Nevada317/wprog/sch/2232/pcb_v10/2232.pdf

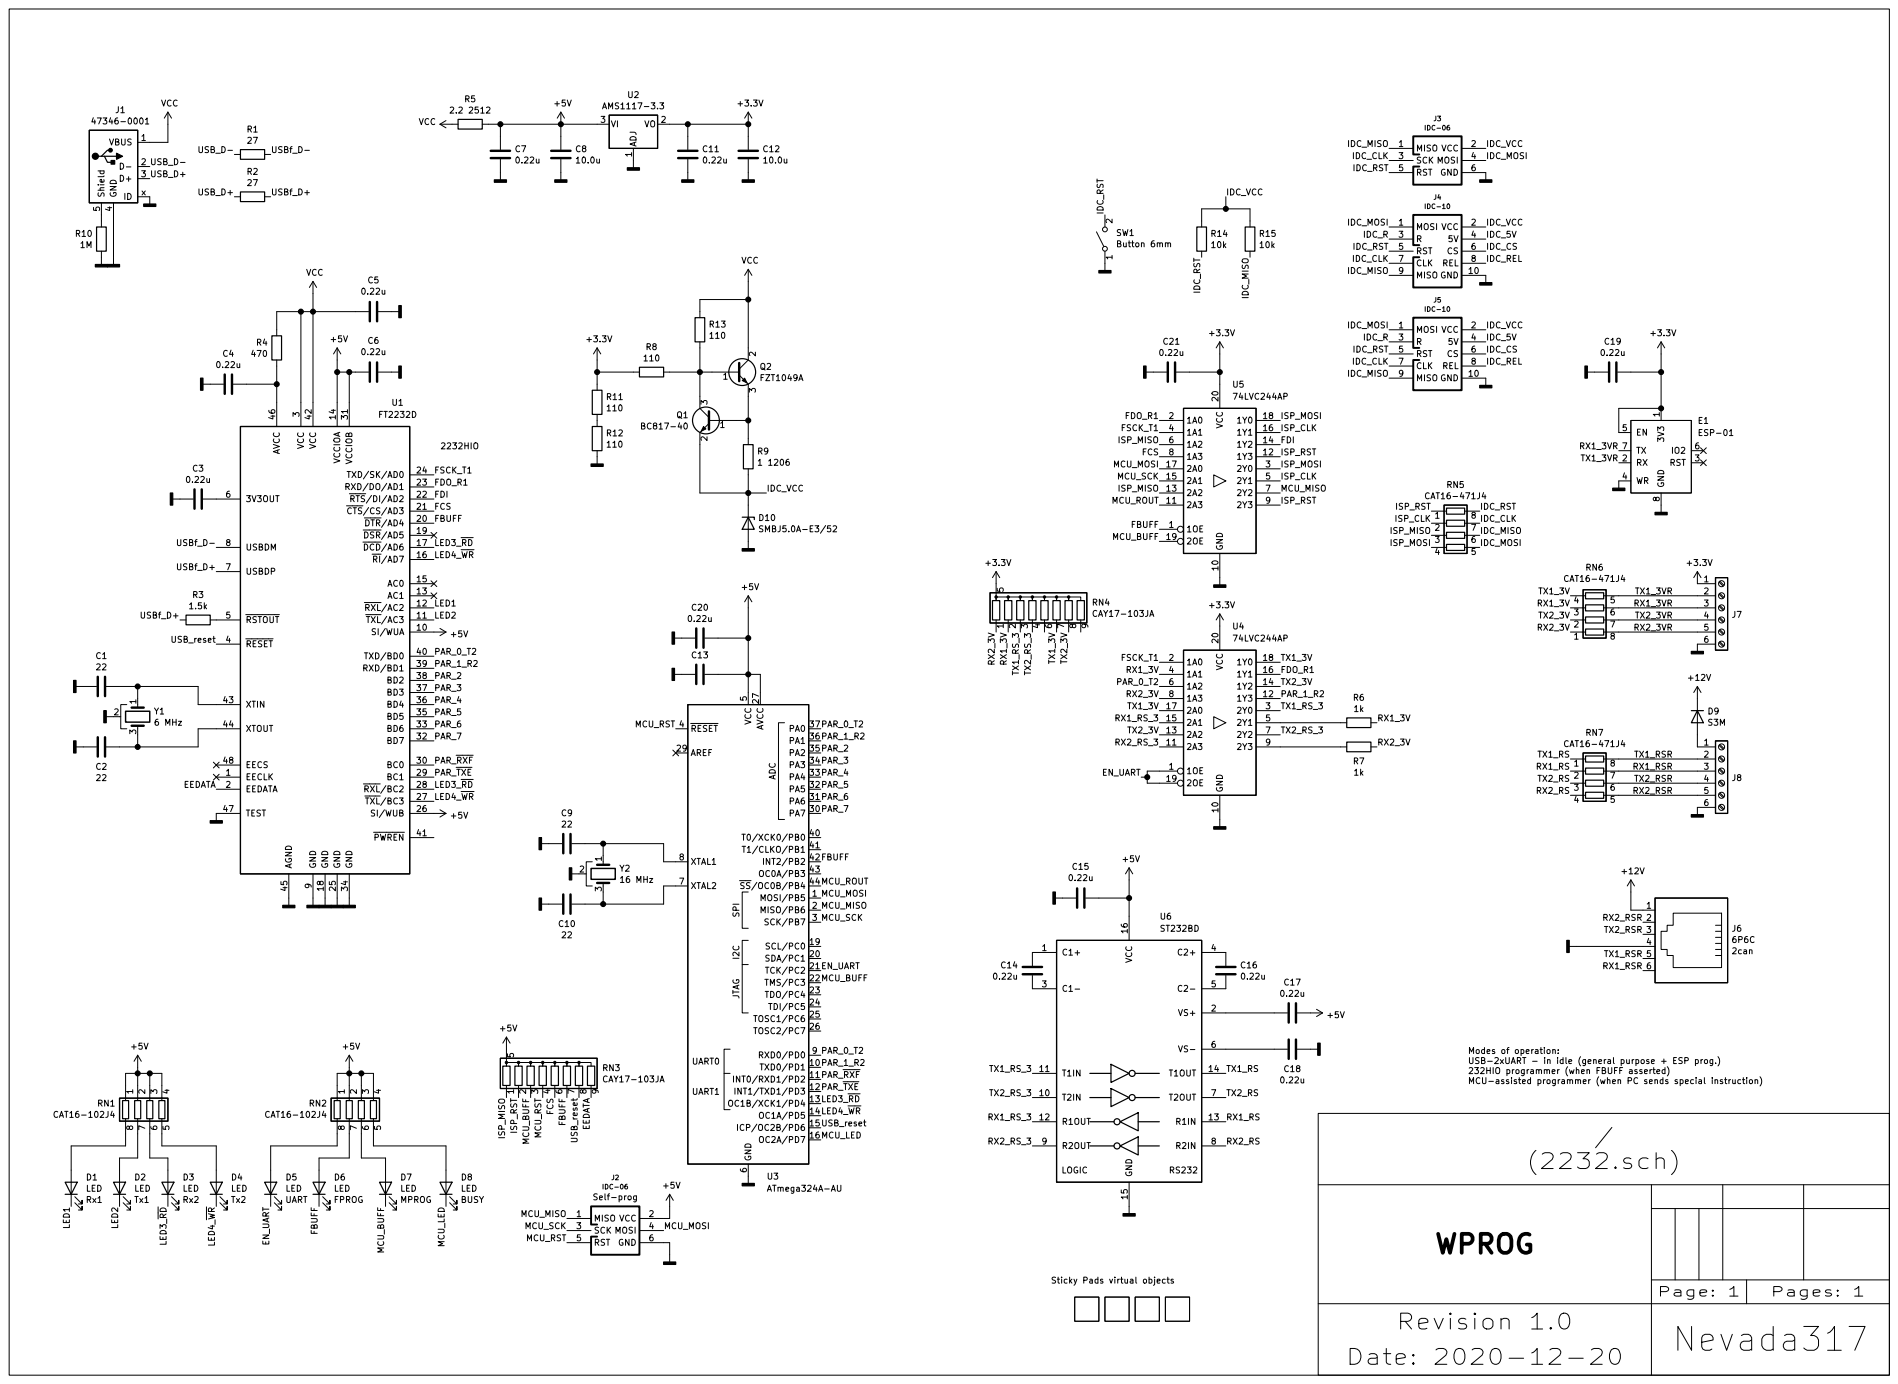
[picture p1: page 1]

3 BC0 30 VCCIOB 31 BD7 32 BD6 33 GND 34 BD5 35 BD4 36 BD3 37 BD2 38 RXD/BD1 39 RESET 4 TXD/BD0 40 PWREN 41 VCC 42 XTIN 43 XTOUT 44 AGND 45 AVCC 46 TEST 47 EECS 48 RSTOUT 5

Modes of operation:
USB-2xUART - in idle (general purpose + ESP prog.)
232HIO programmer (when FBUFF asserted)
MCU-assisted programmer (when PC sends special instruction)

WPROG

Sticky Pads virtual objects

Revision 1.0 Date: 2020-12-20 | Nevada317
