Nevada317/wprog/sch/2232/2232.kicad_pcb

## KiCad design sch/2232/2232.kicad_pcb (2020-12-20)

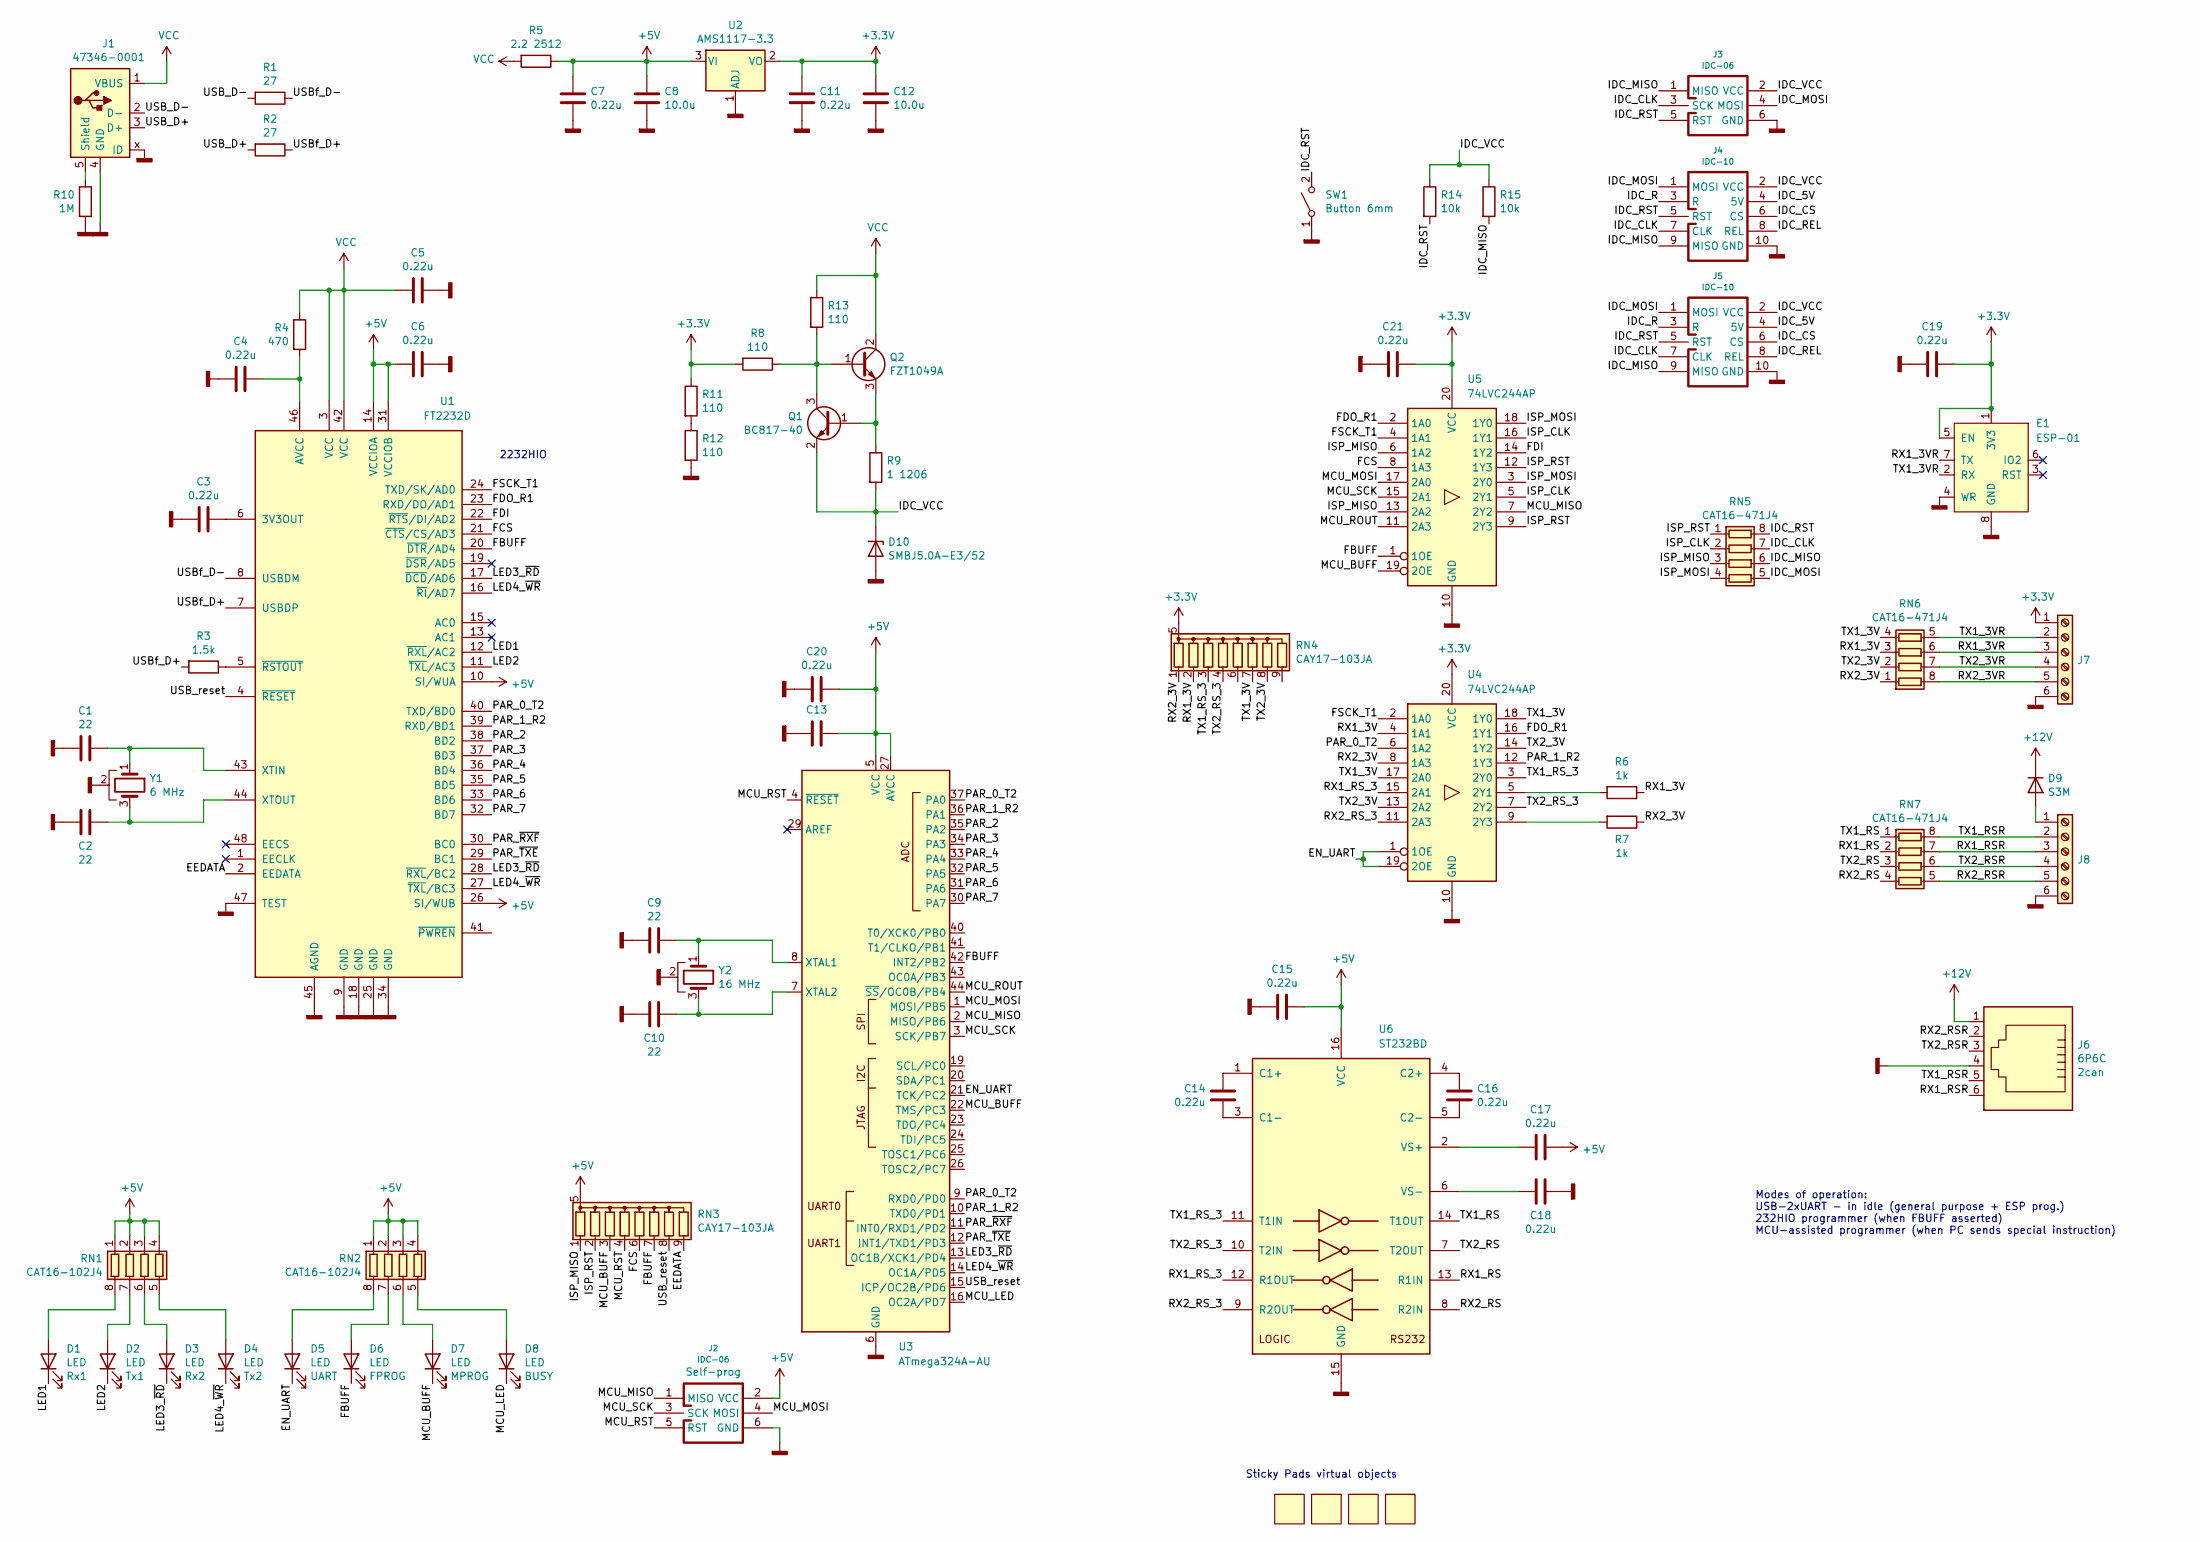
[picture p2: schematic 2232.sch, WPROG]

Parts:
C1, C2, C9, C10: 22; C_0603
C3, C4, C5, C6, C7, C11, C13, C14, C15, C16, C17, C18, C19, C20, C21: 0.22u; C_0603
C8, C12: 10.0u; C_1206
D1, D2, D3, D4, D5, D6, D7, D8: LED; LED_KP-2012G
D9: S3M; DO-214AB_SMC
D10: SMBJ5.0A-E3/52; DO-214AA_SMB
E1: ESP-01
J1: 47346-0001; USB_micro_47346
J2: IDC-06; PLD-6
J3: IDC-06; IDC_Header_Straight_6pins
J4, J5: IDC-10; IDC_Header_Straight_10pins
J6: 6P6C; TJ1A-6P6C_new
J7, J8: Screw_Terminal_01x06; Terminal_3.5mm_x6
Q1: BC817-40; SOT-23
Q2: FZT1049A; SOT-223
R1, R2: 27; R_0603
R3: 1.5k; R_0603
R4: 470; R_0603
R5: 2.2 2512; R_2512
R6, R7: 1k; R_0603
R8, R11, R12, R13: 110; R_0603
R9: 1 1206; R_1206
R10: 1M; R_0603
R14, R15: 10k; R_0603
RN1, RN2: CAT16-102J4; R_CAT-16-4
RN3, RN4: CAY17-103JA; R_CAY17
RN5, RN6, RN7: CAT16-471J4; R_CAT-16-4
SW1: Button 6mm; SW_PUSH_6mm
U1: FT2232D; LQFP-48_7x7mm_P0.5mm
U2: AMS1117-3.3; SOT-223
U3: ATmega324A-AU; TQFP-44
U4, U5: 74LVC244AP; TSSOP-20
U6: ST232BD; SOIC-16
V1, V2, V3, V4: Virtual; StickyPad_13mm
Y1: 6 MHz; Crystal_HC-49SMD
Y2: 16 MHz; Crystal_HC-49SMD

Connections:
+3V3: C11.1, C12.1, C19.1, C21.1, E1.1 (3V3), E1.5 (EN), J7.1, R8.2, R11.1, RN4.5 (common), RN4.10 (common), U2.2 (VO), U4.20 (VCC), U5.20 (VCC)
+5V: C6.1, C7.1, C8.1, C13.1, C15.2, C17.1, C20.1, J2.2 (VCC), R5.1, RN1.1 (R1.1), RN1.2 (R2.1), RN1.3 (R3.1), RN1.4 (R4.1), RN2.1 (R1.1), RN2.2 (R2.1), RN2.3 (R3.1), RN2.4 (R4.1), RN3.5 (common), RN3.10 (common), U1.10 (SI/WUA), U1.14 (VCCIOA), U1.26 (SI/WUB), U1.31 (VCCIOB), U2.3 (VI), U3.5 (VCC), U3.17 (VCC), U3.27 (AVCC), U3.38 (VCC), U6.16 (VCC)
+12V: D9.1 (K), J6.1
/EEDATA: RN3.9 (R8), U1.2 (EEDATA)
/EN_UART: D5.1 (K), U3.21 (TCK/PC2), U4.1 (1OE), U4.19 (2OE)
/FBUFF: D6.1 (K), RN3.7 (R6), U1.20 (~DTR~/AD4), U3.42 (INT2/PB2), U5.1 (1OE)
/FCS: RN3.6 (R5), U1.21 (~CTS~/CS/AD3), U5.8 (1A3)
/FDI: U1.22 (~RTS~/DI/AD2), U5.14 (1Y2)
/FDO_R1: U1.23 (RXD/DO/AD1), U4.16 (1Y1), U5.2 (1A0)
/FSCK_T1: U1.24 (TXD/SK/AD0), U4.2 (1A0), U5.4 (1A1)
/IDC_5V: J4.4 (5V), J5.4 (5V)
/IDC_CLK: J3.3 (SCK), J4.7 (CLK), J5.7 (CLK), RN5.7 (R2.2)
/IDC_CS: J4.6 (CS), J5.6 (CS)
/IDC_MISO: J3.1 (MISO), J4.9 (MISO), J5.9 (MISO), R15.2, RN5.6 (R3.2)
/IDC_MOSI: J3.4 (MOSI), J4.1 (MOSI), J5.1 (MOSI), RN5.5 (R4.2)
/IDC_R: J4.3 (R), J5.3 (R)
/IDC_REL: J4.8 (REL), J5.8 (REL)
/IDC_RST: J3.5 (RST), J4.5 (RST), J5.5 (RST), R14.2, RN5.8 (R1.2), SW1.2 (B)
/IDC_VCC: D10.1 (K), J3.2 (VCC), J4.2 (VCC), J5.2 (VCC), Q1.2 (E), R9.2, R14.1, R15.1
/ISP_CLK: RN5.2 (R2.1), U5.5 (2Y1), U5.16 (1Y1)
/ISP_MISO: RN3.1 (R1), RN5.3 (R3.1), U5.6 (1A2), U5.13 (2A2)
/ISP_MOSI: RN5.4 (R4.1), U5.3 (2Y0), U5.18 (1Y0)
/ISP_RST: RN3.2 (R2), RN5.1 (R1.1), U5.9 (2Y3), U5.12 (1Y3)
/LED1: D1.1 (K), U1.12 (~RXL~/AC2)
/LED2: D2.1 (K), U1.11 (~TXL~/AC3)
/LED3_~RD: D3.1 (K), U1.17 (~DCD~/AD6), U1.28 (~RXL~/BC2), U3.13 (OC1B/XCK1/PD4)
/LED4_~WR: D4.1 (K), U1.16 (~RI~/AD7), U1.27 (~TXL~/BC3), U3.14 (OC1A/PD5)
/MCU_BUFF: D7.1 (K), RN3.3 (R3), U3.22 (TMS/PC3), U5.19 (2OE)
/MCU_LED: D8.1 (K), U3.16 (OC2A/PD7)
/MCU_MISO: J2.1 (MISO), U3.2 (MISO/PB6), U5.7 (2Y2)
/MCU_MOSI: J2.4 (MOSI), U3.1 (MOSI/PB5), U5.17 (2A0)
/MCU_ROUT: U3.44 (~SS~/OC0B/PB4), U5.11 (2A3)
/MCU_RST: J2.5 (RST), RN3.4 (R4), U3.4 (~RESET)
/MCU_SCK: J2.3 (SCK), U3.3 (SCK/PB7), U5.15 (2A1)
/PAR_0_T2: U1.40 (TXD/BD0), U3.9 (RXD0/PD0), U3.37 (PA0), U4.6 (1A2)
/PAR_1_R2: U1.39 (RXD/BD1), U3.10 (TXD0/PD1), U3.36 (PA1), U4.12 (1Y3)
/PAR_2: U1.38 (BD2), U3.35 (PA2)
/PAR_3: U1.37 (BD3), U3.34 (PA3)
/PAR_4: U1.36 (BD4), U3.33 (PA4)
/PAR_5: U1.35 (BD5), U3.32 (PA5)
/PAR_6: U1.33 (BD6), U3.31 (PA6)
/PAR_7: U1.32 (BD7), U3.30 (PA7)
/PAR_~RXF: U1.30 (BC0), U3.11 (INT0/RXD1/PD2)
/PAR_~TXE: U1.29 (BC1), U3.12 (INT1/TXD1/PD3)
/RX1_3V: R6.1, RN4.2 (R2), RN6.3 (R3.1), U4.4 (1A1)
/RX1_3VR: E1.7 (TX), J7.3, RN6.6 (R3.2)
/RX1_RS: RN7.2 (R2.1), U6.13 (R1IN)
/RX1_RSR: J6.6, J8.3, RN7.7 (R2.2)
/RX1_RS_3: U4.15 (2A1), U6.12 (R1OUT)
/RX2_3V: R7.1, RN4.1 (R1), RN6.1 (R1.1), U4.8 (1A3)
/RX2_3VR: J7.5, RN6.8 (R1.2)
/RX2_RS: RN7.4 (R4.1), U6.8 (R2IN)
/RX2_RSR: J6.2, J8.5, RN7.5 (R4.2)
/RX2_RS_3: U4.11 (2A3), U6.9 (R2OUT)
/TX1_3V: RN4.7 (R6), RN6.4 (R4.1), U4.17 (2A0), U4.18 (1Y0)
/TX1_3VR: E1.2 (RX), J7.2, RN6.5 (R4.2)
/TX1_RS: RN7.1 (R1.1), U6.14 (T1OUT)
/TX1_RSR: J6.5, J8.2, RN7.8 (R1.2)
/TX1_RS_3: RN4.3 (R3), U4.3 (2Y0), U6.11 (T1IN)
/TX2_3V: RN4.8 (R7), RN6.2 (R2.1), U4.13 (2A2), U4.14 (1Y2)
/TX2_3VR: J7.4, RN6.7 (R2.2)
/TX2_RS: RN7.3 (R3.1), U6.7 (T2OUT)
/TX2_RSR: J6.3, J8.4, RN7.6 (R3.2)
/TX2_RS_3: RN4.4 (R4), U4.7 (2Y2), U6.10 (T2IN)
/USB_D+: J1.3 (D+), R2.2
/USB_D-: J1.2 (D-), R1.2
/USB_reset: RN3.8 (R7), U1.4 (~RESET), U3.15 (ICP/OC2B/PD6)
/USBf_D+: R2.1, R3.2, U1.7 (USBDP)
/USBf_D-: R1.1, U1.8 (USBDM)
GNDD: C1.2, C2.2, C3.2, C4.2, C5.2, C6.2, C7.2, C8.2, C9.2, C10.2, C11.2, C12.2, C13.2, C15.1, C18.1, C19.2, C20.2, C21.2, D10.2 (A), E1.4 (WR), E1.8 (GND), J1.4 (GND), J1.x (ID), J2.6 (GND), J3.6 (GND), J4.10 (GND), J5.10 (GND), J6.4, J7.6, J8.6, R10.2, R12.2, SW1.1 (A), U1.9 (GND), U1.18 (GND), U1.25 (GND), U1.34 (GND), U1.45 (AGND), U1.47 (TEST), U2.1 (ADJ), U3.6 (GND), U3.18 (GND), U3.28 (GND), U3.39 (GND), U4.10 (GND), U5.10 (GND), U6.15 (GND), Y1.2, Y2.2
unnamed: C1.1, U1.43 (XTIN), Y1.1
unnamed: C2.1, U1.44 (XTOUT), Y1.3
unnamed: C3.1, U1.6 (3V3OUT)
unnamed: C4.1, R4.2, U1.46 (AVCC)
unnamed: C9.1, U3.8 (XTAL1), Y2.1
unnamed: C10.1, U3.7 (XTAL2), Y2.3
unnamed: C14.1, U6.1 (C1+)
unnamed: C14.2, U6.3 (C1-)
unnamed: C16.1, U6.4 (C2+)
unnamed: C16.2, U6.5 (C2-)
unnamed: C17.2, U6.2 (VS+)
unnamed: C18.2, U6.6 (VS-)
unnamed: D1.2 (A), RN1.8 (R1.2)
unnamed: D2.2 (A), RN1.7 (R2.2)
unnamed: D3.2 (A), RN1.6 (R3.2)
unnamed: D4.2 (A), RN1.5 (R4.2)
unnamed: D5.2 (A), RN2.8 (R1.2)
unnamed: D6.2 (A), RN2.7 (R2.2)
unnamed: D7.2 (A), RN2.6 (R3.2)
unnamed: D8.2 (A), RN2.5 (R4.2)
unnamed: D9.2 (A), J8.1
unnamed: J1.5 (Shield), R10.1
unnamed: Q1.1 (B), Q2.3 (E), R9.1
unnamed: Q1.3 (C), Q2.1 (B), R8.1, R13.2
unnamed: R3.1, U1.5 (~RSTOUT)
unnamed: R6.2, U4.5 (2Y1)
unnamed: R7.2, U4.9 (2Y3)
unnamed: R11.2, R12.1
VCC: C5.1, J1.1 (VBUS), Q2.2 (C), R4.1, R5.2, R13.1, U1.3 (VCC), U1.42 (VCC)

Notes on the sheet:
2232HIO
Modes of operation: USB-2xUART - in idle (general purpose + ESP prog.) 232HIO programmer (when FBUFF asserted) MCU-assisted programmer (when PC sends special instruction)
Sticky Pads virtual objects

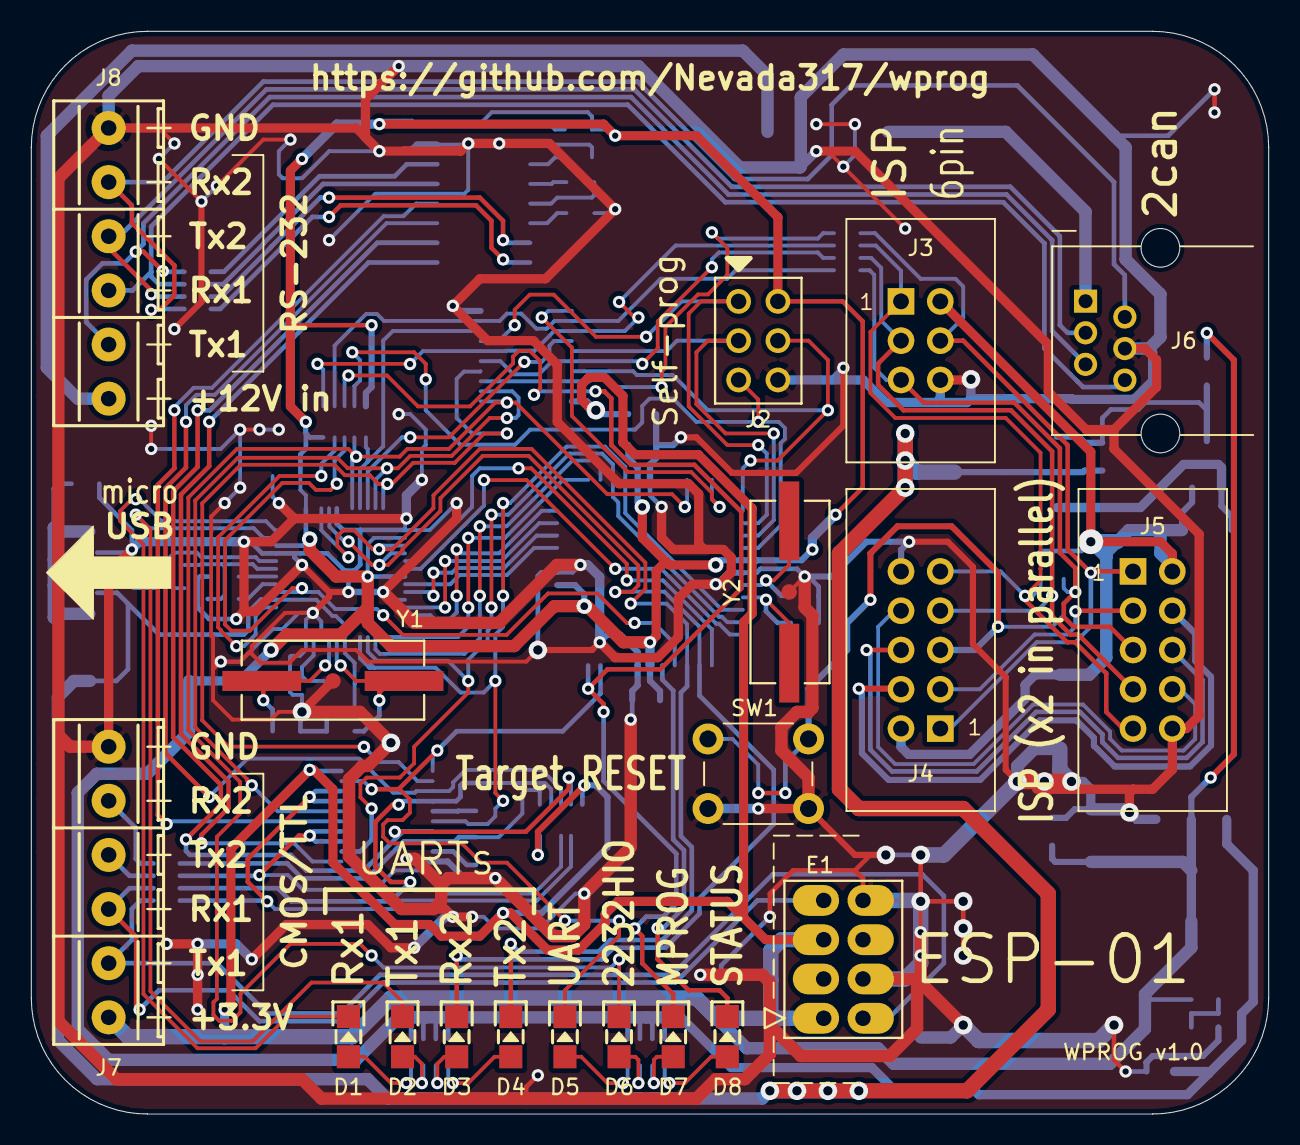
[picture p3: board 2232.kicad_pcb from above]

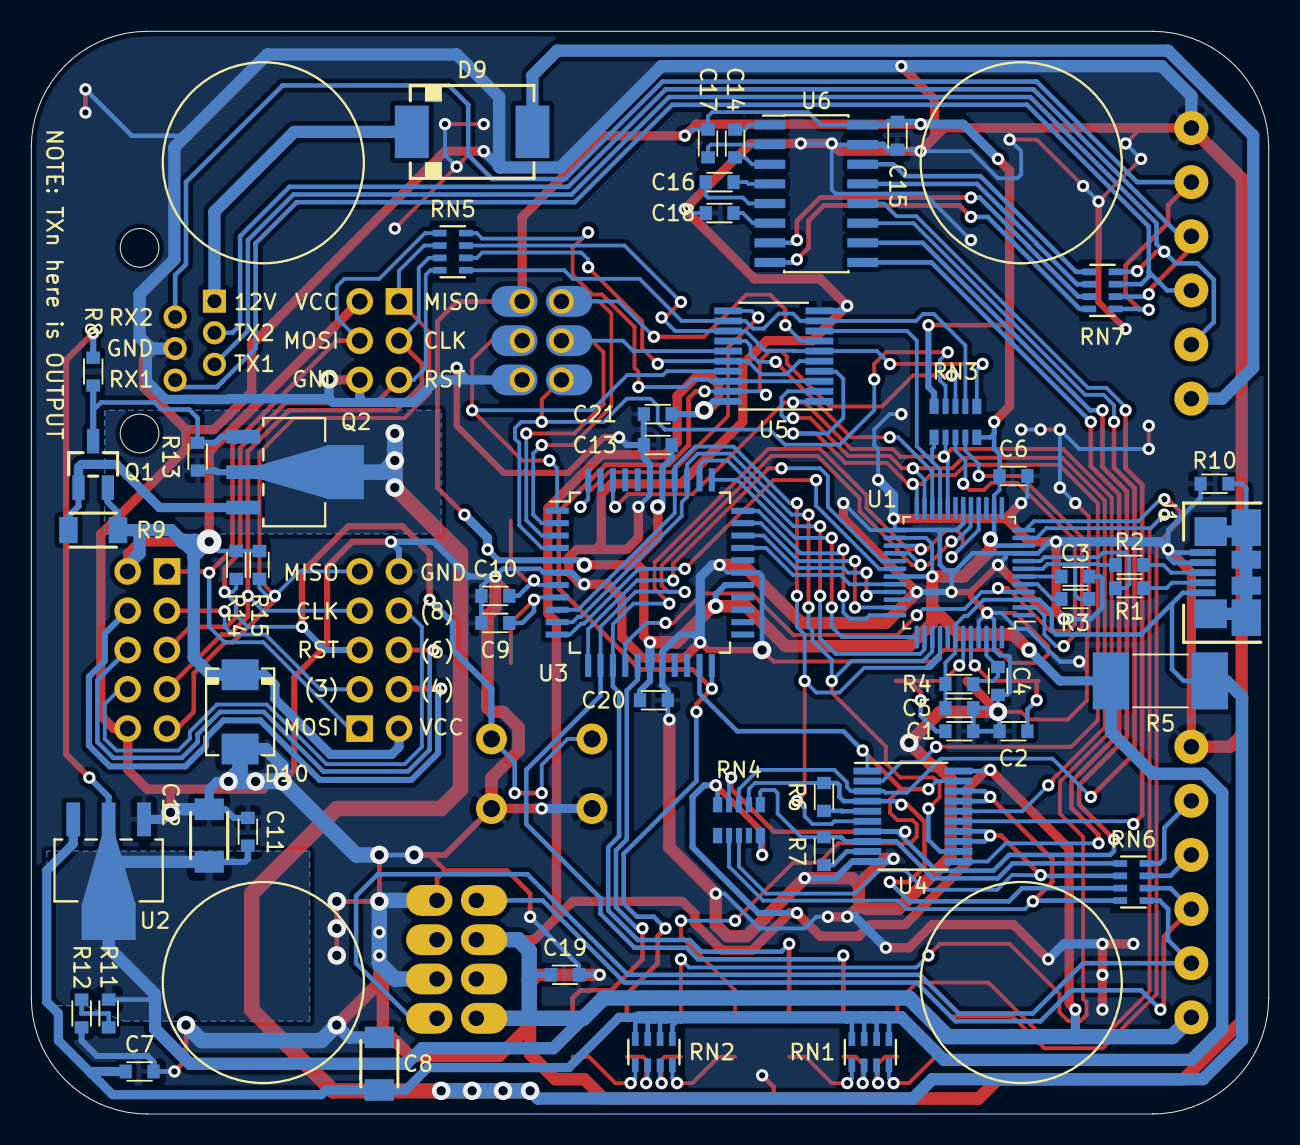
[picture p4: board 2232.kicad_pcb from below]

Board: 2 copper layers, 80.0 x 70.0 mm, 77 parts (58 on the bottom side), 99 nets.
