Nevada317/wprog/(commit log)

2020-12-11 Schematic stub
    [2232.kicad_pcb, 2232.sch]
2020-12-12 Strobes added
    [2232.sch]
2020-12-12 HC138 added
    [2232.sch]
2020-12-12 Names fixed. Footprints assigned
    [2232.sch]
2020-12-12 Annotated. PCB exported
    [2232.kicad_pcb]
2020-12-12 PCB orientation stub
    [2232.kicad_pcb, 2232.sch]
2020-12-12 UART multiplexing
    [2232.kicad_pcb, 2232.sch]
2020-12-13 Routing started
    [2232.kicad_pcb, 2232.sch]
2020-12-14 UARTs routed trough connectors
    [2232.kicad_pcb, 2232.sch]
2020-12-14 All components on-board
    [2232.kicad_pcb, 2232.sch]
2020-12-14 RN remap
    [2232.kicad_pcb, 2232.sch]
2020-12-14 Sides separated
    [2232.kicad_pcb]
2020-12-14 ISP routed
    [2232.kicad_pcb]
2020-12-14 All footprinted elements are routed
    [2232.kicad_pcb, 2232.sch]
2020-12-15 VCC routed
    [2232.kicad_pcb, 2232.sch]
2020-12-15 IDC rotated
    [2232.kicad_pcb]
2020-12-16 No-fill zones
    [2232.kicad_pcb]
2020-12-16 Minor updates
    [2232.kicad_pcb, 2232.sch]
2020-12-19 pcb updates. Looks ready
    [2232.kicad_pcb]
2020-12-19 PCB silk added
    [2232.kicad_pcb]
2020-12-19 Gerbers exported
    [2232-B_Cu.gbr, 2232-B_Mask.gbr, 2232-B_Paste.gbr, 2232-B_SilkS.gbr, 2232-Edge_Cuts.gbr, 2232-F_Cu.gbr, 2232-F_Mask.gbr, 2232-F_Paste.gbr]
2020-12-19 STEP models update
    [2232.kicad_pcb]
2020-12-20 Pullups to RST and MISO added
    [2232-B_Cu.gbr, 2232-B_Mask.gbr, 2232-B_Paste.gbr, 2232-B_SilkS.gbr, 2232-Edge_Cuts.gbr, 2232-F_Cu.gbr, 2232-F_Mask.gbr, 2232-F_Paste.gbr]
2020-12-20 Silk updates
    [2232.kicad_pcb]
2020-12-20 Reset button added
    [2232-B_Cu.gbr, 2232-B_Mask.gbr, 2232-B_Paste.gbr, 2232-B_SilkS.gbr, 2232-Edge_Cuts.gbr, 2232-F_Cu.gbr, 2232-F_Mask.gbr, 2232-F_Paste.gbr]
2020-12-26 Pin init
2021-01-05 UART Rx stub added
2021-01-06 tty.c inserted
2021-01-06 UART looks like working
2021-01-07 Transport parcel - raw parcel generated and printed
2021-01-07 Reader in separate thread added
2021-01-07 Removet bunch of useless printf's
2021-01-11 Remove nasty warning in test case
